nikitalita/PicoCart64/hw/picocart64_v2/README.md

# PicoCart64 v2.0

:exclamation: Do not produce PCBs based on this yet, boards are untested! :exclamation:

## Errata

### v1.0
- TBD

## Changelog

### v1.0
