nikitalita/PicoCart64/hw/picocart64_v2/picocart64_v2-0.png

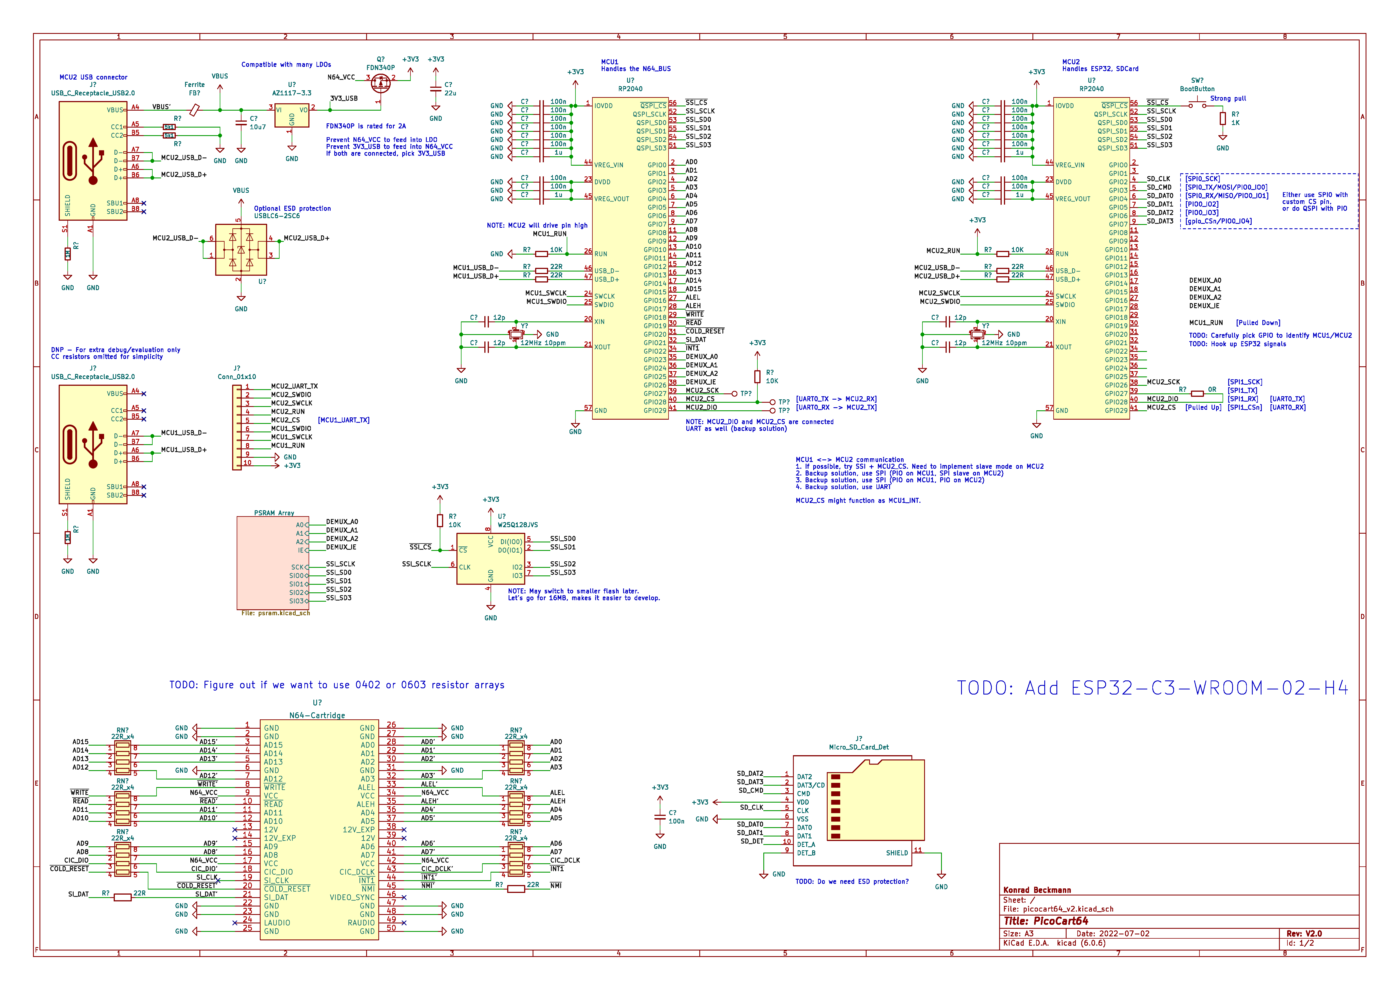
hw/picocart64_v2/picocart64_v2-0.png
