nikitalita/PicoCart64/hw/picocart64_v2/picocart64_v2-1.png

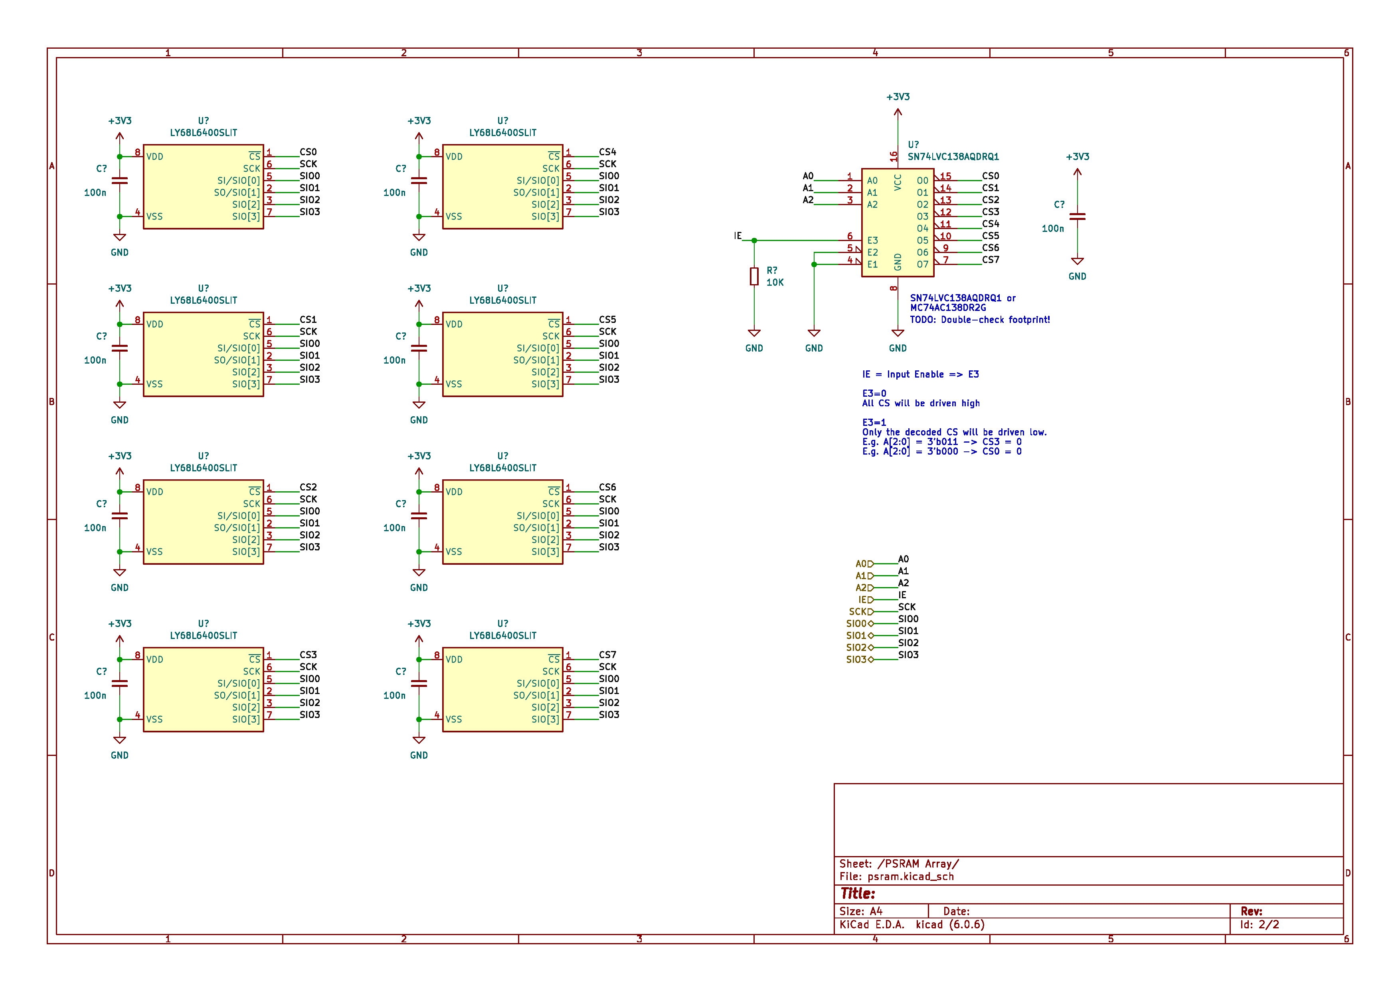
hw/picocart64_v2/picocart64_v2-1.png
