nikitalita/PicoCart64/hw/picocart64_v2/picocart64_v2.pdf

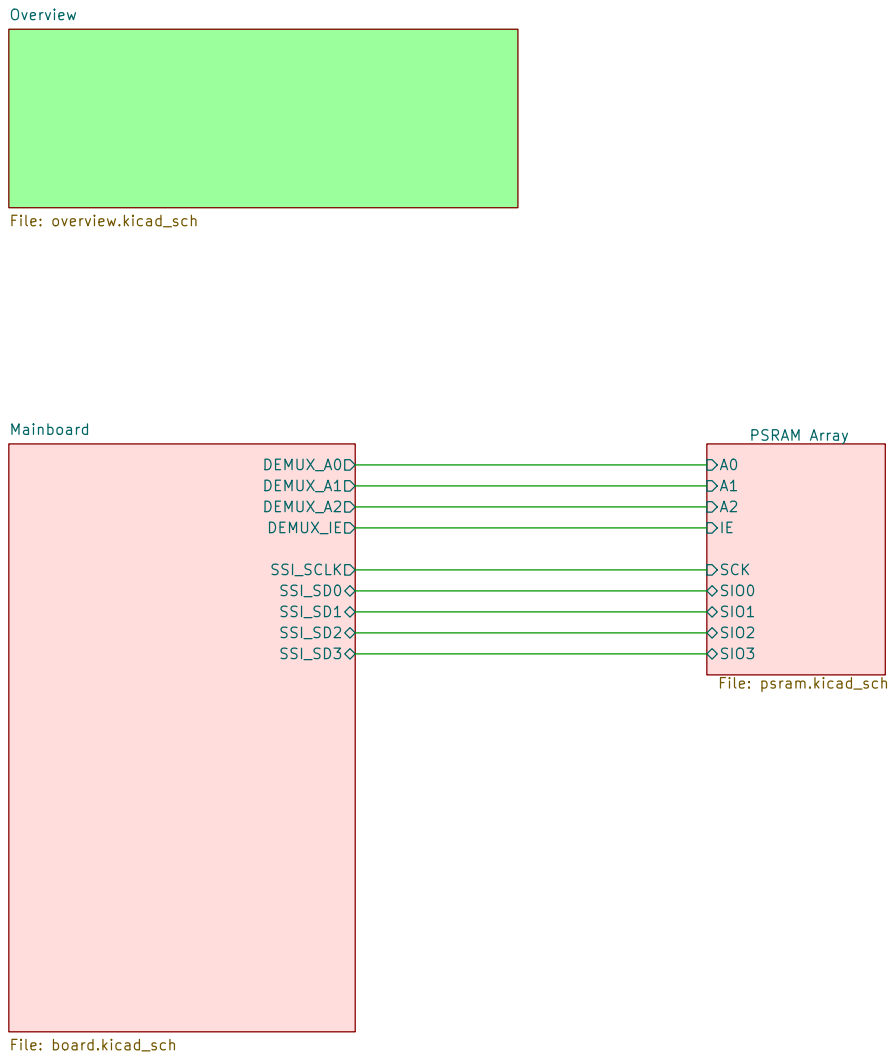
[picture p3: page 1]

File: picocart64_v2.kicad_sch Sheet: / Konrad Beckmann

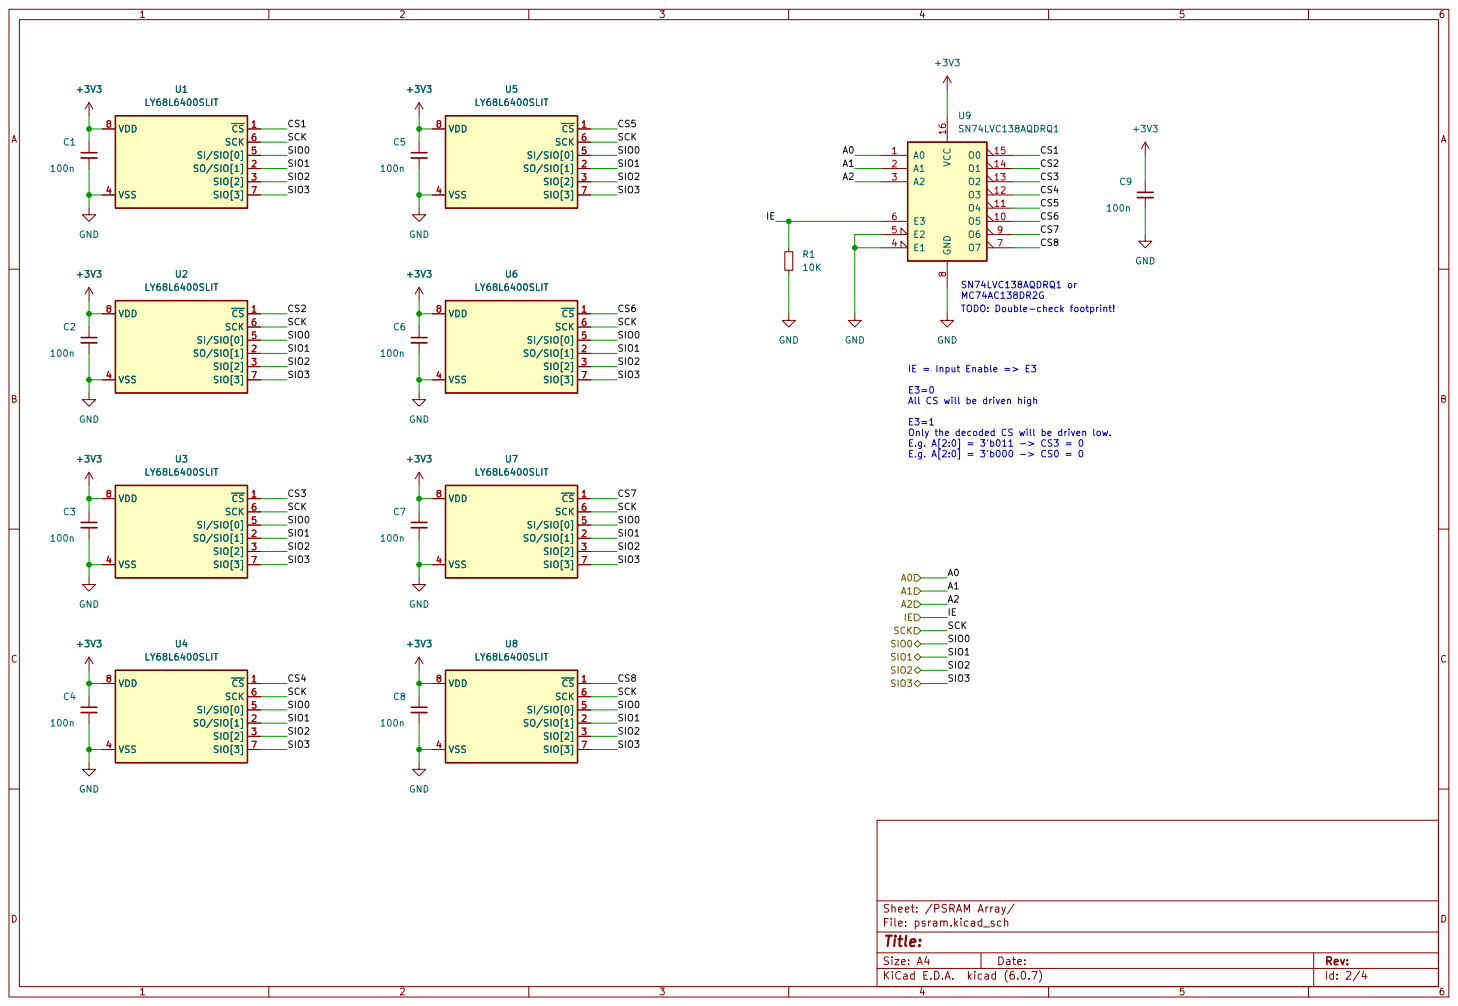
[picture p4: page 2]

TODO: Double-check footprint!

IE = Input Enable => E3 E3=0 All CS will be driven high E3=1 Only the decoded CS will be driven low.

Sheet: /PSRAM Array/ GND

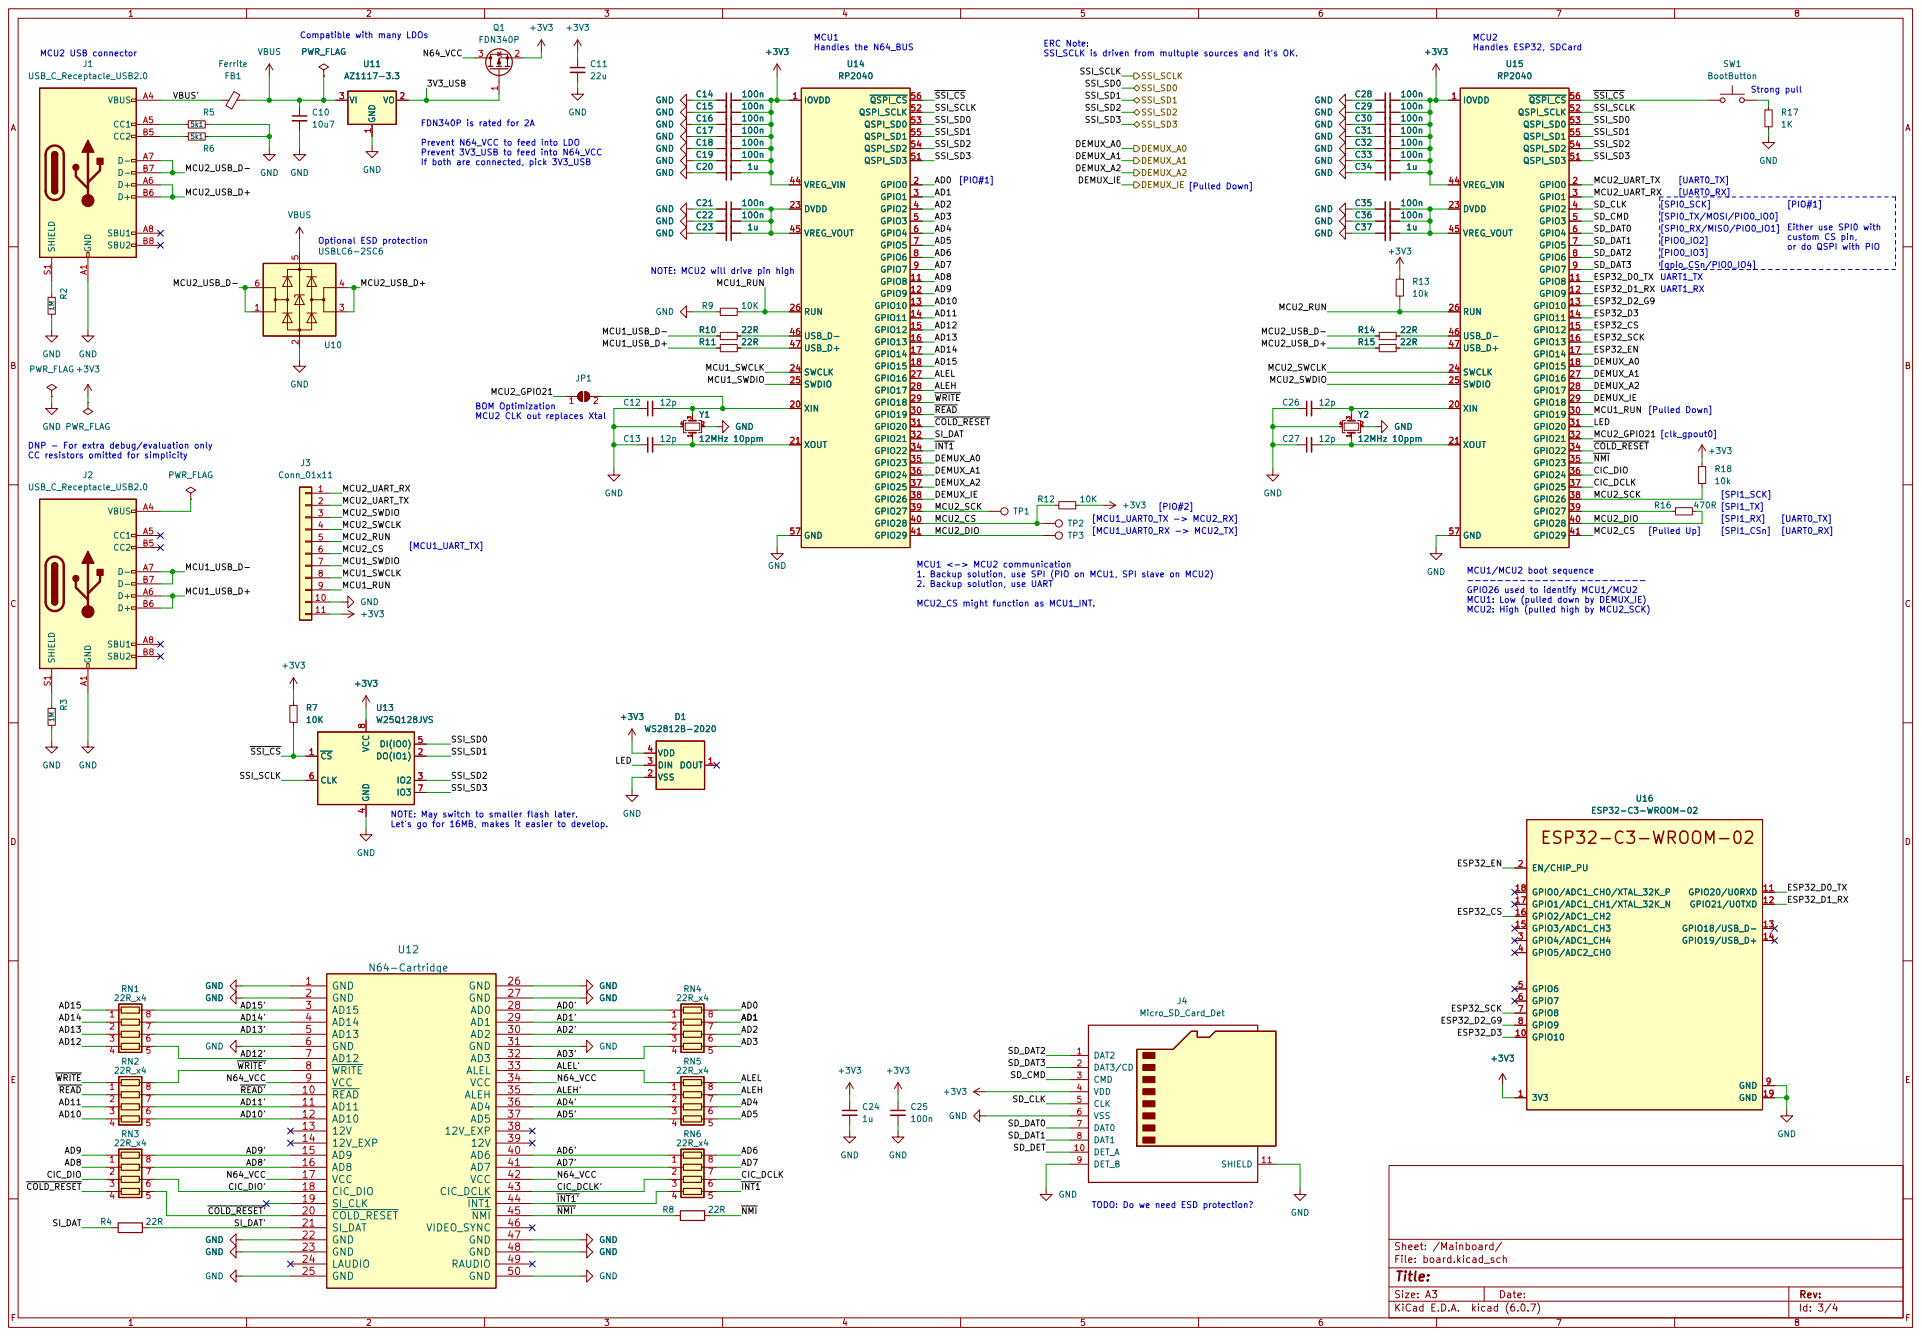
[picture p5: page 3]

[MCU1_UART0_TX -> MCU2_RX] MCU1 Handles the N64_BUS Compatible with many LDOs
PWR_FLAG

[gpio_CSn/PIO0_IO4] ERC Note: SSI_SCLK is driven from multuple sources and it's OK.

1 VO 2 VI 3 U11 AZ1117-3.3 GND GND

Strong pull FDN340P is rated for 2A

Prevent N64_VCC to feed into LDO
Prevent 3V3_USB to feed into N64_VCC
If both are connected, pick 3V3_USB

[PIO0_IO2] UART1_RX NOTE: MCU2 will drive pin high

Either use SPI0 with
custom CS pin, or do QSPI with PIO

BOM Optimization
MCU2 CLK out replaces Xtal

DNP - For extra debug/evaluation only
CC resistors omitted for simplicity
MCU1_USB_D+ CIC_DIO

1. Backup solution, use SPI (PIO on MCU1, SPI slave on MCU2)
2. Backup solution, use UART

MCU1: Low (pulled down by DEMUX_IE)

MCU2: High (pulled high by MCU2_SCK) +3V3 U13 W25Q128JVS

8 D1 WS2812B-2020 DOUT 1 VSS 2 DIN 3 VDD 4 +3V3 R7

NOTE: May switch to smaller flash later.
Let's go for 16MB, makes it easier to develop.

TODO: Do we need ESD protection?

File: board.kicad_sch Sheet: /Mainboard/

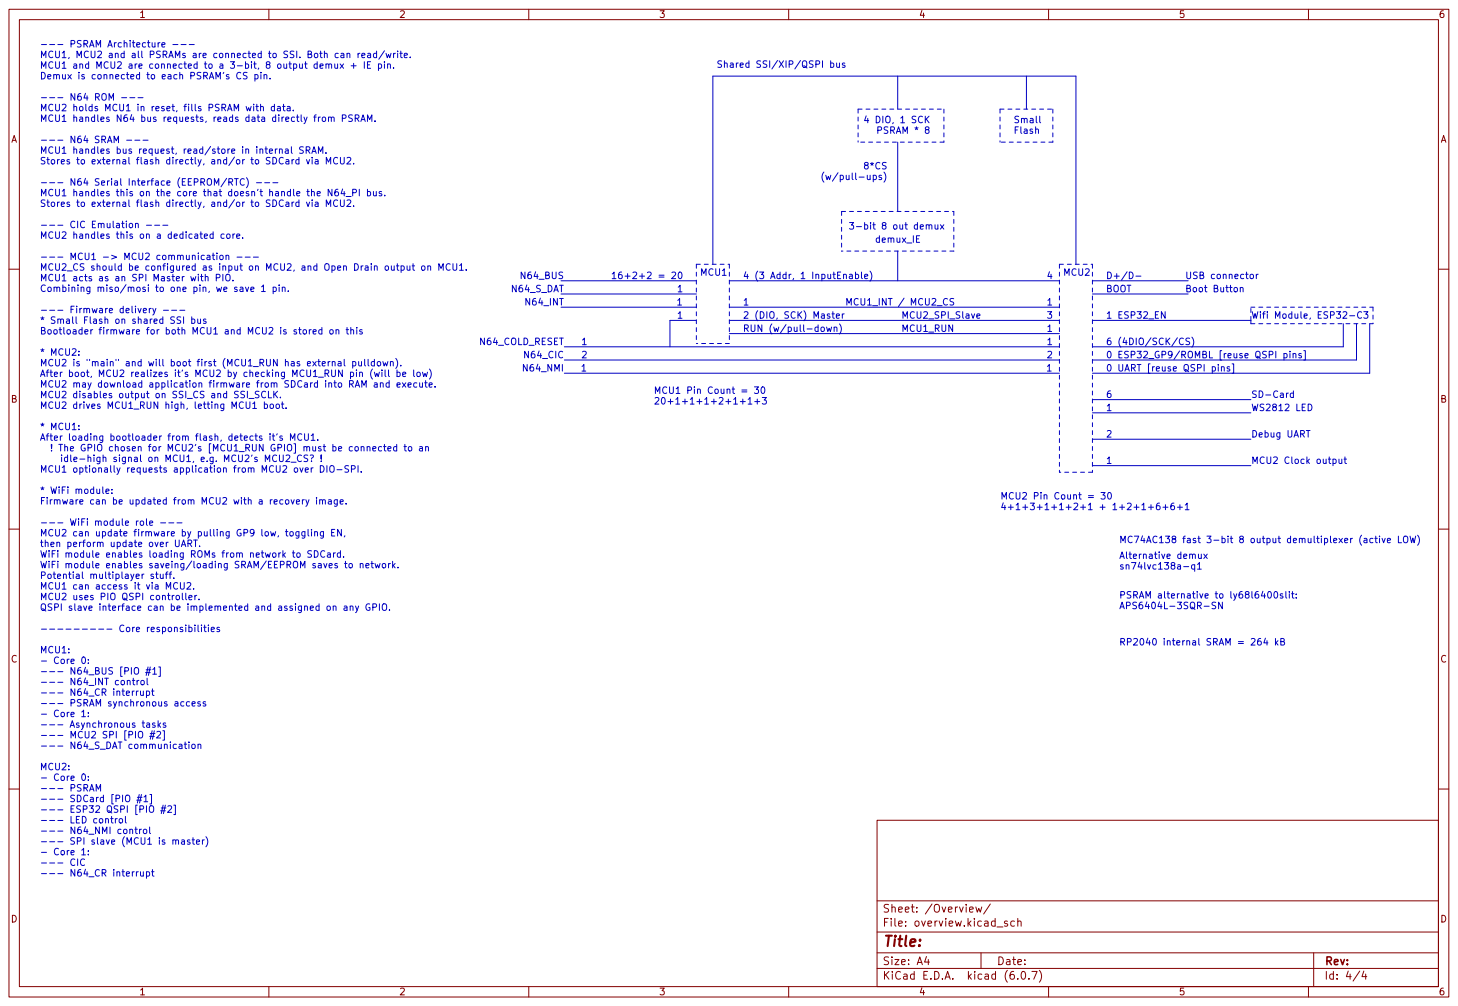
[picture p6: page 4]

--- PSRAM Architecture --- MCU1, MCU2 and all PSRAMs are connected to SSI. Both can read/write. MCU1 and MCU2 are connected to a 3-bit, 8 output demux + IE pin.

Demux is connected to each PSRAM's CS pin. --- N64 ROM --- MCU2 holds MCU1 in reset, fills PSRAM with data. MCU1 handles N64 bus requests, reads data directly from PSRAM. --- N64 SRAM --- MCU1 handles bus request, read/store in internal SRAM.

6 (4DIO/SCK/CS) Small Flash
USB connector PSRAM alternative to ly68l6400slit: APS6404L-3SQR-SN

Stores to external flash directly, and/or to SDCard via MCU2.

--- N64 Serial Interface (EEPROM/RTC) --- MCU1 handles this on the core that doesn't handle the N64_PI bus. Stores to external flash directly, and/or to SDCard via MCU2. --- CIC Emulation --- MCU2 handles this on a dedicated core. --- MCU1 -> MCU2 communication --- MCU2_CS should be configured as input on MCU2, and Open Drain output on MCU1. MCU1 acts as an SPI Master with PIO. Combining miso/mosi to one pin, we save 1 pin.

0 ESP32_GP9/ROMBL [reuse QSPI pins] demux_IE

--- Firmware delivery --- * Small Flash on shared SSI bus Bootloader firmware for both MCU1 and MCU2 is stored on this

* MCU2: MCU2 is "main" and will boot first (MCU1_RUN has external pulldown).

After boot, MCU2 realizes it's MCU2 by checking MCU1_RUN pin (will be low)
MCU2 may download application firmware from SDCard into RAM and execute.
MCU2 disables output on SSI_CS and SSI_SCLK.
MCU2 drives MCU1_RUN high, letting MCU1 boot. * MCU1: After loading bootloader from flash, detects it's MCU1.

0 UART [reuse QSPI pins]

! The GPIO chosen for MCU2's [MCU1_RUN GPIO] must be connected to an
idle-high signal on MCU1, e.g. MCU2's MCU2_CS? !
MCU1 optionally requests application from MCU2 over DIO-SPI. * WiFi module: Firmware can be updated from MCU2 with a recovery image. --- WiFi module role --- MCU2 can update firmware by pulling GP9 low, toggling EN,

then perform update over UART.
WiFi module enables loading ROMs from network to SDCard.
WiFi module enables saveing/loading SRAM/EEPROM saves to network.
Potential multiplayer stuff. MCU1 can access it via MCU2. MCU2 uses PIO QSPI controller. QSPI slave interface can be implemented and assigned on any GPIO.

--------- Core responsibilities MCU1: - Core 0: --- N64_BUS [PIO #1] --- N64_INT control --- N64_CR interrupt

--- MCU2 SPI [PIO #2] --- N64_S_DAT communication MCU2: - Core 0: --- PSRAM

--- SDCard [PIO #1]
--- ESP32 QSPI [PIO #2] --- LED control --- N64_NMI control --- SPI slave (MCU1 is master)

File: overview.kicad_sch Sheet: /Overview/
Id: 4/4 Title:
