nikitalita/PicoCart64/hw/picocart64_v2/picocart64_v2.kicad_pcb

## KiCad design hw/picocart64_v2/picocart64_v2.kicad_pcb (2022-08-11)

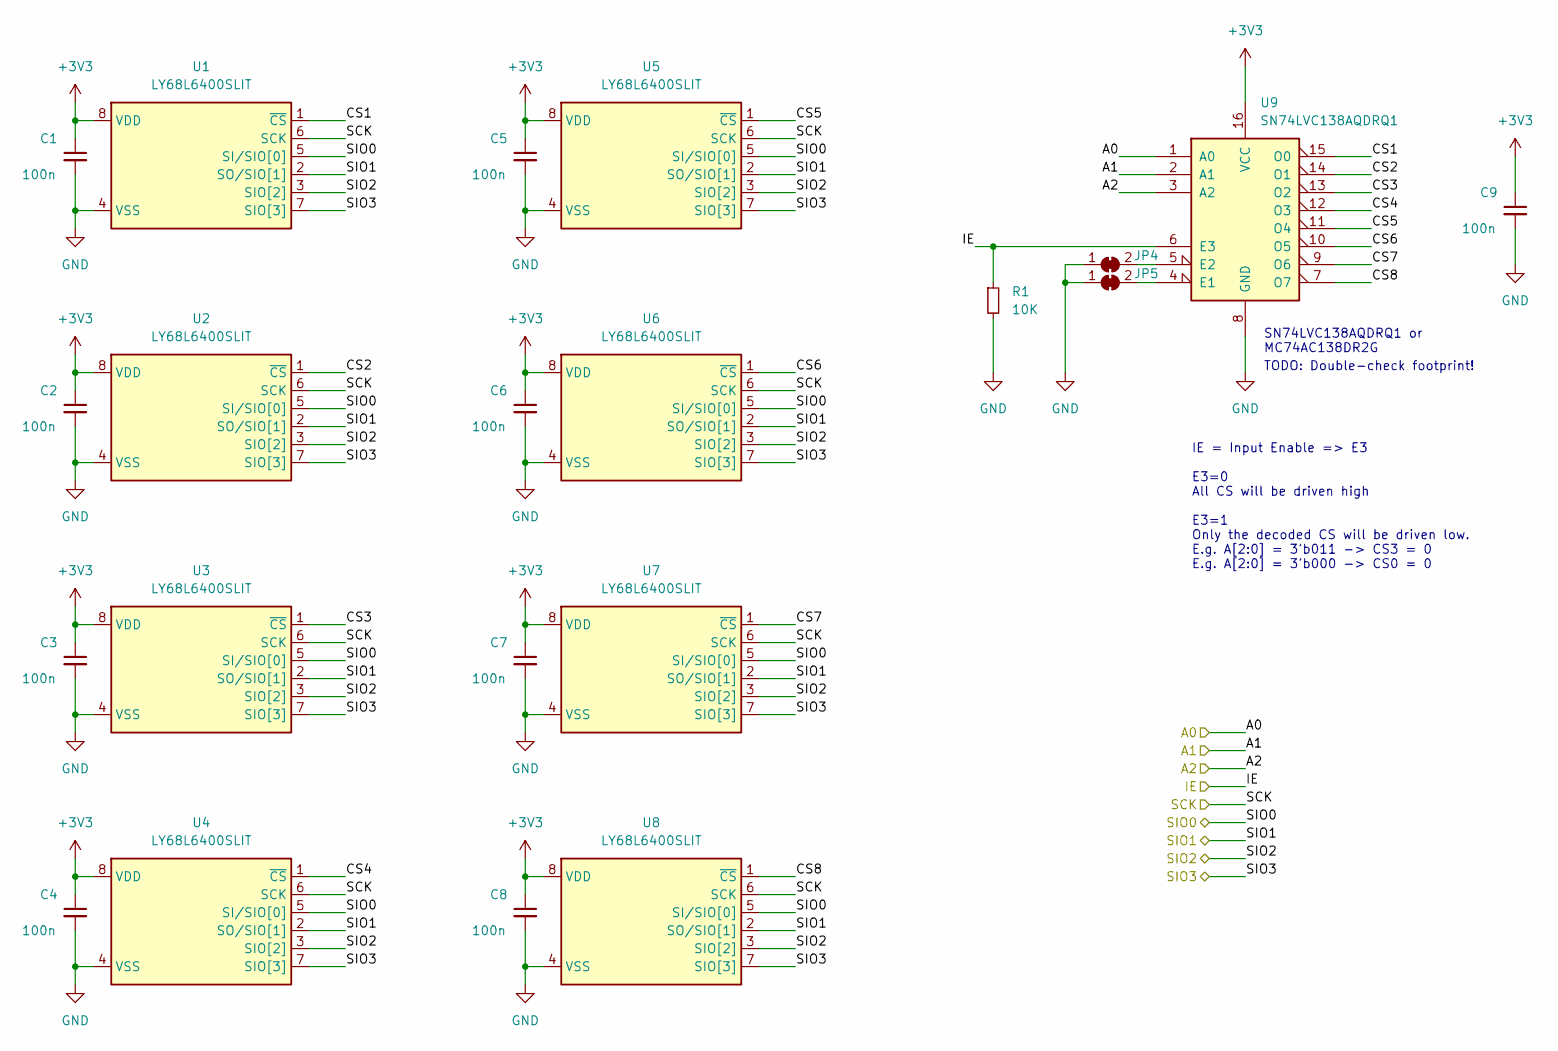
[picture p7: schematic psram.kicad_sch]

Parts:
C1, C2, C3, C4, C5, C6, C7, C8, C9: 100n; C_0402_1005Metric
JP4, JP5: SolderJumper_2_Bridged; SolderJumper-2_Small_Closed
R1: 10K; R_0402_1005Metric
U1, U2, U3, U4, U5, U6, U7, U8: LY68L6400SLIT; SOIC-8_5.275x5.275mm_P1.27mm
U9: SN74LVC138AQDRQ1; SOP-16_4.4x10.4mm_P1.27mm

Connections:
+3V3: C1.1, C2.1, C3.1, C4.1, C5.1, C6.1, C7.1, C8.1, C9.1, U1.8 (VDD), U2.8 (VDD), U3.8 (VDD), U4.8 (VDD), U5.8 (VDD), U6.8 (VDD), U7.8 (VDD), U8.8 (VDD), U9.16 (VCC); also elsewhere on the board
/Mainboard/DEMUX_A0: U9.1 (A0); also elsewhere on the board
/Mainboard/DEMUX_A1: U9.2 (A1); also elsewhere on the board
/Mainboard/DEMUX_A2: U9.3 (A2); also elsewhere on the board
/Mainboard/DEMUX_IE: R1.1, U9.6 (E3); also elsewhere on the board
/Mainboard/SSI_SCLK: U1.6 (SCK), U2.6 (SCK), U3.6 (SCK), U4.6 (SCK), U5.6 (SCK), U6.6 (SCK), U7.6 (SCK), U8.6 (SCK); also elsewhere on the board
/Mainboard/SSI_SD0: U1.5 (SI/SIO[0]), U2.5 (SI/SIO[0]), U3.5 (SI/SIO[0]), U4.5 (SI/SIO[0]), U5.5 (SI/SIO[0]), U6.5 (SI/SIO[0]), U7.5 (SI/SIO[0]), U8.5 (SI/SIO[0]); also elsewhere on the board
/Mainboard/SSI_SD1: U1.2 (SO/SIO[1]), U2.2 (SO/SIO[1]), U3.2 (SO/SIO[1]), U4.2 (SO/SIO[1]), U5.2 (SO/SIO[1]), U6.2 (SO/SIO[1]), U7.2 (SO/SIO[1]), U8.2 (SO/SIO[1]); also elsewhere on the board
/Mainboard/SSI_SD2: U1.3 (SIO[2]), U2.3 (SIO[2]), U3.3 (SIO[2]), U4.3 (SIO[2]), U5.3 (SIO[2]), U6.3 (SIO[2]), U7.3 (SIO[2]), U8.3 (SIO[2]); also elsewhere on the board
/Mainboard/SSI_SD3: U1.7 (SIO[3]), U2.7 (SIO[3]), U3.7 (SIO[3]), U4.7 (SIO[3]), U5.7 (SIO[3]), U6.7 (SIO[3]), U7.7 (SIO[3]), U8.7 (SIO[3]); also elsewhere on the board
/PSRAM Array/CS1: U1.1 (~CS), U9.15 (O0)
/PSRAM Array/CS2: U2.1 (~CS), U9.14 (O1)
/PSRAM Array/CS3: U3.1 (~CS), U9.13 (O2)
/PSRAM Array/CS4: U4.1 (~CS), U9.12 (O3)
/PSRAM Array/CS5: U5.1 (~CS), U9.11 (O4)
/PSRAM Array/CS6: U6.1 (~CS), U9.10 (O5)
/PSRAM Array/CS7: U7.1 (~CS), U9.9 (O6)
/PSRAM Array/CS8: U8.1 (~CS), U9.7 (O7)
GND: C1.2, C2.2, C3.2, C4.2, C5.2, C6.2, C7.2, C8.2, C9.2, JP4.1 (A), JP5.1 (A), R1.2, U1.4 (VSS), U2.4 (VSS), U3.4 (VSS), U4.4 (VSS), U5.4 (VSS), U6.4 (VSS), U7.4 (VSS), U8.4 (VSS), U9.8 (GND); also elsewhere on the board
unnamed: JP4.2 (B), U9.5 (E2)
unnamed: JP5.2 (B), U9.4 (E1)

Notes on the sheet:
TODO: Double-check footprint!
IE = Input Enable => E3 E3=0 All CS will be driven high E3=1 Only the decoded CS will be driven low. E.g. A[2:0] = 3'b011 -> CS3 = 0 E.g. A[2:0] = 3'b000 -> CS0 = 0
SN74LVC138AQDRQ1 or MC74AC138DR2G

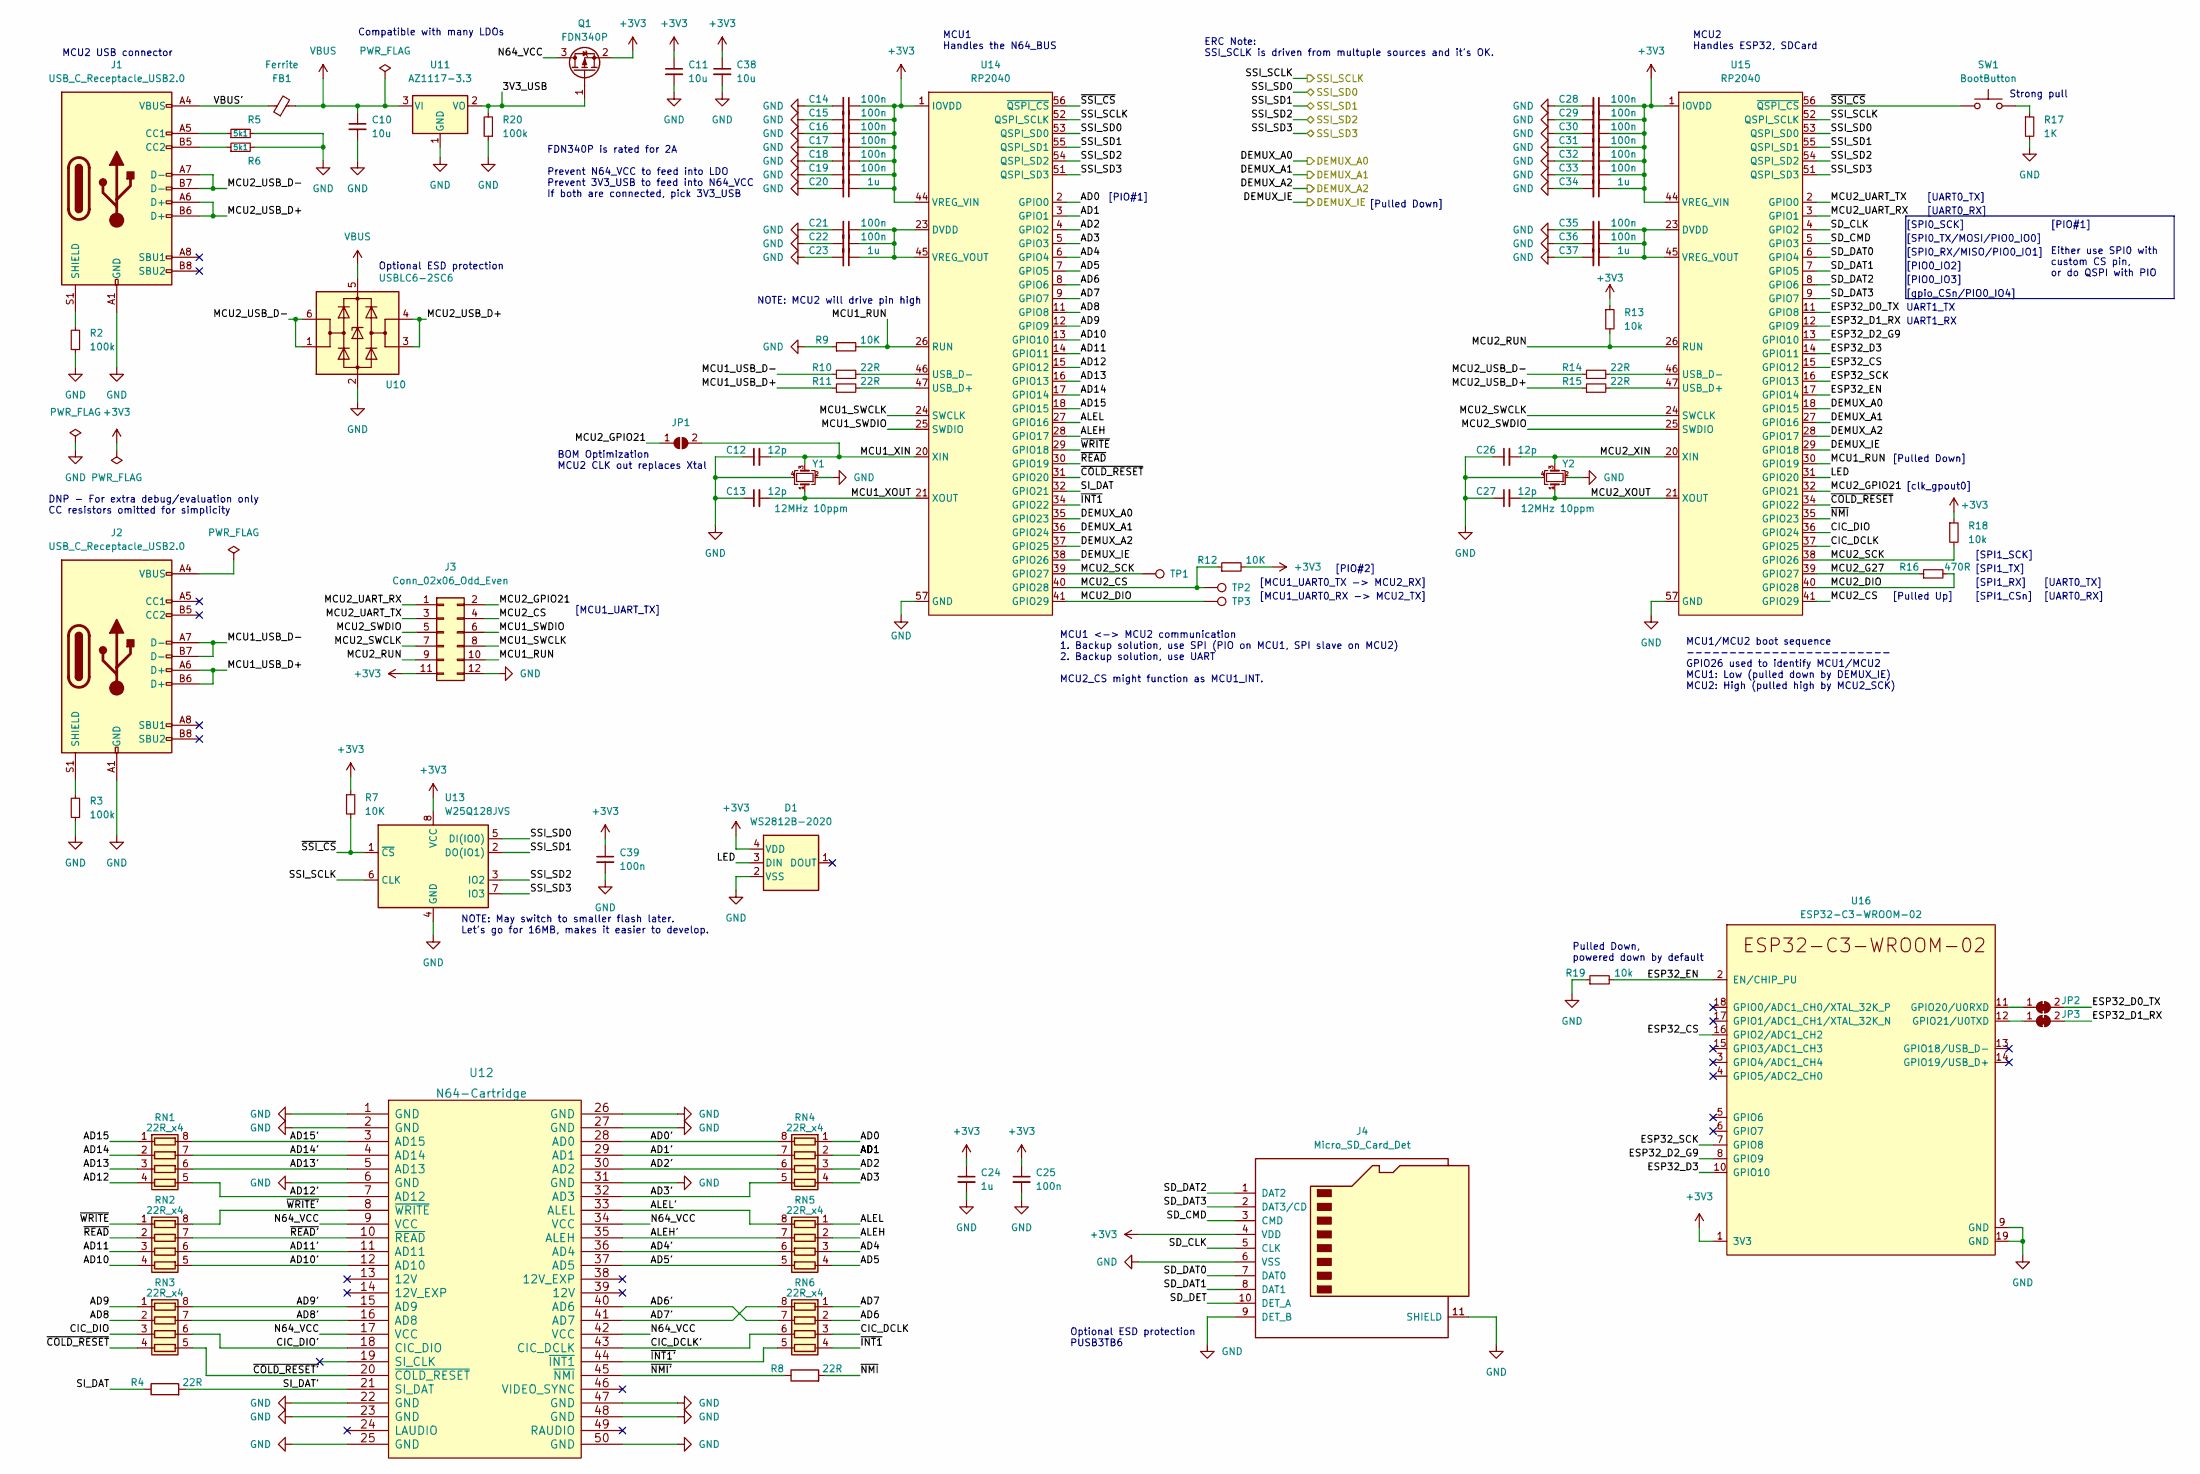
[picture p8: schematic board.kicad_sch]

Parts:
C10, C11, C38: 10u; C_0603_1608Metric
C12, C13, C26, C27: 12p; C_0402_1005Metric
C14, C15, C16, C17, C18, C19, C21, C22, C25, C28, C29, C30, C31, C32, C33, C35, C36, C39: 100n; C_0402_1005Metric
C20, C23, C24, C34, C37: 1u; C_0402_1005Metric
D1: WS2812B-2020
FB1: Ferrite; L_0603_1608Metric
J1, J2: USB_C_Receptacle_USB2.0; USB_C_Receptacle_GT-USB-7010
J3: Conn_02x06_Odd_Even; PinHeader_2x06_P2.54mm_Vertical_SMD
J4: Micro_SD_Card_Det; microSD_HC_Molex_104031-0811
JP1: SolderJumper_2_Open; SolderJumper-2_Small_Open
JP2, JP3: SolderJumper_2_Bridged; SolderJumper-2_Small_Closed
Q1: FDN340P; SOT-23; LCSC C347510
R2, R3, R20: 100k; R_0402_1005Metric
R4, R8, R10, R11, R14, R15: 22R; R_0402_1005Metric
R5, R6: 5k1; R_0402_1005Metric
R7, R9, R12: 10K; R_0402_1005Metric
R13, R18, R19: 10k; R_0402_1005Metric
R16: 470R; R_0402_1005Metric
R17: 1K; R_0402_1005Metric
RN1, RN2, RN3, RN4, RN5, RN6: 22R_x4; R_Array_Convex_4x0402
SW1: BootButton; SW_SPST_FSMSM
TP1: TP_MCU2_SCK; TestPoint_Pad_D1.0mm
TP2: TP_MCU2_CS; TestPoint_Pad_D1.0mm
TP3: TP_MCU2_DIO; TestPoint_Pad_D1.0mm
U10: USBLC6-2SC6; SOT-23-6; LCSC1 C15999
U11: AZ1117-3.3; SOT-223
U12: N64-Cartridge; N64-Connector
U13: W25Q128JVS; SOIC-8_5.23x5.23mm_P1.27mm
U14, U15: RP2040; QFN-56_EP_7x7_Pitch0.4mm
U16: ESP32-C3-WROOM-02
Y1, Y2: 12MHz 10ppm; Crystal_SMD_2520-4Pin_2.5x2.0mm; LCSC C521567

Connections:
+3V3: C11.1, C14.1, C15.1, C16.1, C17.1, C18.1, C19.1, C20.1, C24.1, C25.1, C28.1, C29.1, C30.1, C31.1, C32.1, C33.1, C34.1, C38.1, C39.1, D1.4 (VDD), J3.11, J4.4 (VDD), Q1.2 (S), R7.1, R12.2, R13.1, R18.1, U13.8 (VCC), U14.1 (IOVDD), U14.10 (IOVDD), U14.22 (IOVDD), U14.33 (IOVDD), U14.42 (IOVDD), U14.43 (ADC_AVDD), U14.44 (VREG_VIN), U14.48 (USB_VDD), U14.49 (IOVDD), U15.1 (IOVDD), U15.10 (IOVDD), U15.22 (IOVDD), U15.33 (IOVDD), U15.42 (IOVDD), U15.43 (ADC_AVDD), U15.44 (VREG_VIN), U15.48 (USB_VDD), U15.49 (IOVDD), U16.1 (3V3); also elsewhere on the board
/Mainboard/3V3_USB: Q1.1 (G), R20.2, U11.2 (VO)
/Mainboard/AD0: RN4.1 (R1.1), U14.2 (GPIO0)
/Mainboard/AD0': RN4.8 (R1.2), U12.28 (AD0)
/Mainboard/AD1: RN4.2 (R2.1), U14.3 (GPIO1)
/Mainboard/AD1': RN4.7 (R2.2), U12.29 (AD1)
/Mainboard/AD2: RN4.3 (R3.1), U14.4 (GPIO2)
/Mainboard/AD2': RN4.6 (R3.2), U12.30 (AD2)
/Mainboard/AD3: RN4.4 (R4.1), U14.5 (GPIO3)
/Mainboard/AD3': RN4.5 (R4.2), U12.32 (AD3)
/Mainboard/AD4: RN5.3 (R3.1), U14.6 (GPIO4)
/Mainboard/AD4': RN5.6 (R3.2), U12.36 (AD4)
/Mainboard/AD5: RN5.4 (R4.1), U14.7 (GPIO5)
/Mainboard/AD5': RN5.5 (R4.2), U12.37 (AD5)
/Mainboard/AD6: RN6.2 (R2.1), U14.8 (GPIO6)
/Mainboard/AD6': RN6.7 (R2.2), U12.40 (AD6)
/Mainboard/AD7: RN6.1 (R1.1), U14.9 (GPIO7)
/Mainboard/AD7': RN6.8 (R1.2), U12.41 (AD7)
/Mainboard/AD8: RN3.2 (R2.1), U14.11 (GPIO8)
/Mainboard/AD8': RN3.7 (R2.2), U12.16 (AD8)
/Mainboard/AD9: RN3.1 (R1.1), U14.12 (GPIO9)
/Mainboard/AD9': RN3.8 (R1.2), U12.15 (AD9)
/Mainboard/AD10: RN2.4 (R4.1), U14.13 (GPIO10)
/Mainboard/AD10': RN2.5 (R4.2), U12.12 (AD10)
/Mainboard/AD11: RN2.3 (R3.1), U14.14 (GPIO11)
/Mainboard/AD11': RN2.6 (R3.2), U12.11 (AD11)
/Mainboard/AD12: RN1.4 (R4.1), U14.15 (GPIO12)
/Mainboard/AD12': RN1.5 (R4.2), U12.7 (AD12)
/Mainboard/AD13: RN1.3 (R3.1), U14.16 (GPIO13)
/Mainboard/AD13': RN1.6 (R3.2), U12.5 (AD13)
/Mainboard/AD14: RN1.2 (R2.1), U14.17 (GPIO14)
/Mainboard/AD14': RN1.7 (R2.2), U12.4 (AD14)
/Mainboard/AD15: RN1.1 (R1.1), U14.18 (GPIO15)
/Mainboard/AD15': RN1.8 (R1.2), U12.3 (AD15)
/Mainboard/ALEH: RN5.2 (R2.1), U14.28 (GPIO17)
/Mainboard/ALEH': RN5.7 (R2.2), U12.35 (ALEH)
/Mainboard/ALEL: RN5.1 (R1.1), U14.27 (GPIO16)
/Mainboard/ALEL': RN5.8 (R1.2), U12.33 (ALEL)
/Mainboard/CIC_DCLK: RN6.3 (R3.1), U15.37 (GPIO25)
/Mainboard/CIC_DCLK': RN6.6 (R3.2), U12.43 (CIC_DCLK)
/Mainboard/CIC_DIO: RN3.3 (R3.1), U15.36 (GPIO24)
/Mainboard/CIC_DIO': RN3.6 (R3.2), U12.18 (CIC_DIO)
/Mainboard/DEMUX_A0: U14.35 (GPIO23), U15.18 (GPIO15); also elsewhere on the board
/Mainboard/DEMUX_A1: U14.36 (GPIO24), U15.27 (GPIO16); also elsewhere on the board
/Mainboard/DEMUX_A2: U14.37 (GPIO25), U15.28 (GPIO17); also elsewhere on the board
/Mainboard/DEMUX_IE: U14.38 (GPIO26), U15.29 (GPIO18); also elsewhere on the board
/Mainboard/ESP32_CS: U15.15 (GPIO12), U16.16 (GPIO2/ADC1_CH2)
/Mainboard/ESP32_D0_TX: JP2.2 (B), U15.11 (GPIO8)
/Mainboard/ESP32_D1_RX: JP3.2 (B), U15.12 (GPIO9)
/Mainboard/ESP32_D2_G9: U15.13 (GPIO10), U16.8 (GPIO9)
/Mainboard/ESP32_D3: U15.14 (GPIO11), U16.10 (GPIO10)
/Mainboard/ESP32_EN: R19.2, U15.17 (GPIO14), U16.2 (EN/CHIP_PU)
/Mainboard/ESP32_SCK: U15.16 (GPIO13), U16.7 (GPIO8)
/Mainboard/LED: D1.3 (DIN), U15.31 (GPIO20)
/Mainboard/MCU1_RUN: J3.10, R9.2, U14.26 (RUN), U15.30 (GPIO19)
/Mainboard/MCU1_SWCLK: J3.8, U14.24 (SWCLK)
/Mainboard/MCU1_SWDIO: J3.6, U14.25 (SWDIO)
/Mainboard/MCU1_USB_D+: J2.A6 (D+), J2.B6 (D+), R11.1
/Mainboard/MCU1_USB_D-: J2.A7 (D-), J2.B7 (D-), R10.1
/Mainboard/MCU1_XIN: C12.2, JP1.2 (B), U14.20 (XIN), Y1.3
/Mainboard/MCU1_XOUT: C13.2, U14.21 (XOUT), Y1.1
/Mainboard/MCU2_CS: J3.4, R12.1, TP2.1, U14.40 (GPIO28), U15.41 (GPIO29)
/Mainboard/MCU2_DIO: R16.2, TP3.1, U14.41 (GPIO29), U15.40 (GPIO28)
/Mainboard/MCU2_G27: R16.1, U15.39 (GPIO27)
/Mainboard/MCU2_GPIO21: J3.2, JP1.1 (A), U15.32 (GPIO21)
/Mainboard/MCU2_RUN: J3.9, R13.2, U15.26 (RUN)
/Mainboard/MCU2_SCK: R18.2, TP1.1, U14.39 (GPIO27), U15.38 (GPIO26)
/Mainboard/MCU2_SWCLK: J3.7, U15.24 (SWCLK)
/Mainboard/MCU2_SWDIO: J3.5, U15.25 (SWDIO)
/Mainboard/MCU2_UART_RX: J3.1, U15.3 (GPIO1)
/Mainboard/MCU2_UART_TX: J3.3, U15.2 (GPIO0)
/Mainboard/MCU2_USB_D+: J1.A6 (D+), J1.B6 (D+), R15.1, U10.3 (I/O2), U10.4 (I/O2)
/Mainboard/MCU2_USB_D-: J1.A7 (D-), J1.B7 (D-), R14.1, U10.1 (I/O1), U10.6 (I/O1)
/Mainboard/MCU2_XIN: C26.2, U15.20 (XIN), Y2.3
/Mainboard/MCU2_XOUT: C27.2, U15.21 (XOUT), Y2.1
/Mainboard/N64_VCC: Q1.3 (D), U12.9 (VCC), U12.17 (VCC), U12.34 (VCC), U12.42 (VCC)
/Mainboard/SD_CLK: J4.5 (CLK), U15.4 (GPIO2)
/Mainboard/SD_CMD: J4.3 (CMD), U15.5 (GPIO3)
/Mainboard/SD_DAT0: J4.7 (DAT0), U15.6 (GPIO4)
/Mainboard/SD_DAT1: J4.8 (DAT1), U15.7 (GPIO5)
/Mainboard/SD_DAT2: J4.1 (DAT2), U15.8 (GPIO6)
/Mainboard/SD_DAT3: J4.2 (DAT3/CD), U15.9 (GPIO7)
/Mainboard/SD_DET: J4.10 (DET_A)
/Mainboard/SI_DAT: R4.1, U14.32 (GPIO21)
/Mainboard/SI_DAT': R4.2, U12.21 (SI_DAT)
/Mainboard/SSI_SCLK: U13.6 (CLK), U14.52 (QSPI_SCLK), U15.52 (QSPI_SCLK); also elsewhere on the board
/Mainboard/SSI_SD0: U13.5 (DI(IO0)), U14.53 (QSPI_SD0), U15.53 (QSPI_SD0); also elsewhere on the board
/Mainboard/SSI_SD1: U13.2 (DO(IO1)), U14.55 (QSPI_SD1), U15.55 (QSPI_SD1); also elsewhere on the board
/Mainboard/SSI_SD2: U13.3 (IO2), U14.54 (QSPI_SD2), U15.54 (QSPI_SD2); also elsewhere on the board
/Mainboard/SSI_SD3: U13.7 (IO3), U14.51 (QSPI_SD3), U15.51 (QSPI_SD3); also elsewhere on the board
/Mainboard/VBUS': FB1.1, J1.A4 (VBUS), J1.A9 (VBUS), J1.B4 (VBUS), J1.B9 (VBUS)
/Mainboard/~COLD_RESET': RN3.5 (R4.2), U12.20 (~COLD_RESET)
/Mainboard/~COLD_RESET: RN3.4 (R4.1), U14.31 (GPIO20), U15.34 (GPIO22)
/Mainboard/~INT1': RN6.5 (R4.2), U12.44 (~INT1)
/Mainboard/~INT1: RN6.4 (R4.1), U14.34 (GPIO22)
/Mainboard/~NMI': R8.1, U12.45 (~NMI)
/Mainboard/~NMI: R8.2, U15.35 (GPIO23)
/Mainboard/~READ': RN2.7 (R2.2), U12.10 (~READ)
/Mainboard/~READ: RN2.2 (R2.1), U14.30 (GPIO19)
/Mainboard/~SSI_CS: R7.2, SW1.1, U13.1 (~CS), U14.56 (~QSPI_CS), U15.56 (~QSPI_CS)
/Mainboard/~WRITE': RN2.8 (R1.2), U12.8 (~WRITE)
/Mainboard/~WRITE: RN2.1 (R1.1), U14.29 (GPIO18)
GND: C10.2, C11.2, C12.1, C13.1, C14.2, C15.2, C16.2, C17.2, C18.2, C19.2, C20.2, C21.2, C22.2, C23.2, C24.2, C25.2, C26.1, C27.1, C28.2, C29.2, C30.2, C31.2, C32.2, C33.2, C34.2, C35.2, C36.2, C37.2, C38.2, C39.2, D1.2 (VSS), J1.A1 (GND), J1.A12 (GND), J1.B1 (GND), J1.B12 (GND), J2.A1 (GND), J2.A12 (GND), J2.B1 (GND), J2.B12 (GND), J3.12, J4.6 (VSS), J4.9 (DET_B), J4.11 (SHIELD), R2.1, R3.1, R5.2, R6.2, R9.1, R17.2, R19.1, R20.1, U10.2 (GND), U11.1 (GND), U12.1 (GND), U12.2 (GND), U12.6 (GND), U12.22 (GND), U12.23 (GND), U12.25 (GND), U12.26 (GND), U12.27 (GND), U12.31 (GND), U12.47 (GND), U12.48 (GND), U12.50 (GND), U13.4 (GND), U14.19 (TESTEN), U14.57 (GND), U15.19 (TESTEN), U15.57 (GND), U16.9 (GND), U16.19 (GND), Y1.2, Y1.4, Y2.2, Y2.4; also elsewhere on the board
unnamed: C21.1, C22.1, C23.1, U14.23 (DVDD), U14.45 (VREG_VOUT), U14.50 (DVDD)
unnamed: C35.1, C36.1, C37.1, U15.23 (DVDD), U15.45 (VREG_VOUT), U15.50 (DVDD)
unnamed: J1.A5 (CC1), R5.1
unnamed: J1.B5 (CC2), R6.1
unnamed: J1.S1 (SHIELD), R2.2
unnamed: J2.A4 (VBUS), J2.A9 (VBUS), J2.B4 (VBUS), J2.B9 (VBUS)
unnamed: J2.S1 (SHIELD), R3.2
unnamed: JP2.1 (A), U16.11 (GPIO20/U0RXD)
unnamed: JP3.1 (A), U16.12 (GPIO21/U0TXD)
unnamed: R10.2, U14.46 (USB_D-)
unnamed: R11.2, U14.47 (USB_D+)
unnamed: R14.2, U15.46 (USB_D-)
unnamed: R15.2, U15.47 (USB_D+)
unnamed: R17.1, SW1.2
VBUS: C10.1, FB1.2, U10.5 (VBUS), U11.3 (VI)

Notes on the sheet:
[UART0_TX]
[PIO0_IO2]
[Pulled Up]
[clk_gpout0]
UART1_TX
[MCU1_UART0_RX -> MCU2_TX]
NOTE: MCU2 will drive pin high
[Pulled Down]
Strong pull
[UART0_RX]
MCU2 Handles ESP32, SDCard
FDN340P is rated for 2A Prevent N64_VCC to feed into LDO Prevent 3V3_USB to feed into N64_VCC If both are connected, pick 3V3_USB
Optional ESD protection PUSB3TB6
[PIO#1]
Compatible with many LDOs
NOTE: May switch to smaller flash later. Let's go for 16MB, makes it easier to develop.
UART1_RX
BOM Optimization MCU2 CLK out replaces Xtal
[SPI1_SCK]
[SPI0_TX/MOSI/PIO0_IO0]
MCU1/MCU2 boot sequence ------------------------ GPIO26 used to identify MCU1/MCU2 MCU1: Low (pulled down by DEMUX_IE) MCU2: High (pulled high by MCU2_SCK)
[SPI0_SCK]
Either use SPI0 with custom CS pin, or do QSPI with PIO
[MCU1_UART_TX]
[SPI1_TX]
[MCU1_UART0_TX -> MCU2_RX]
[SPI1_RX]
ERC Note: SSI_SCLK is driven from multuple sources and it's OK.
MCU2 USB connector
[PIO0_IO3]
[PIO#2]
Optional ESD protection
MCU1 <-> MCU2 communication 1. Backup solution, use SPI (PIO on MCU1, SPI slave on MCU2) 2. Backup solution, use UART MCU2_CS might function as MCU1_INT.
[SPI0_RX/MISO/PIO0_IO1]
Pulled Down, powered down by default
DNP - For extra debug/evaluation only CC resistors omitted for simplicity
MCU1 Handles the N64_BUS
[gpio_CSn/PIO0_IO4]
[SPI1_CSn]

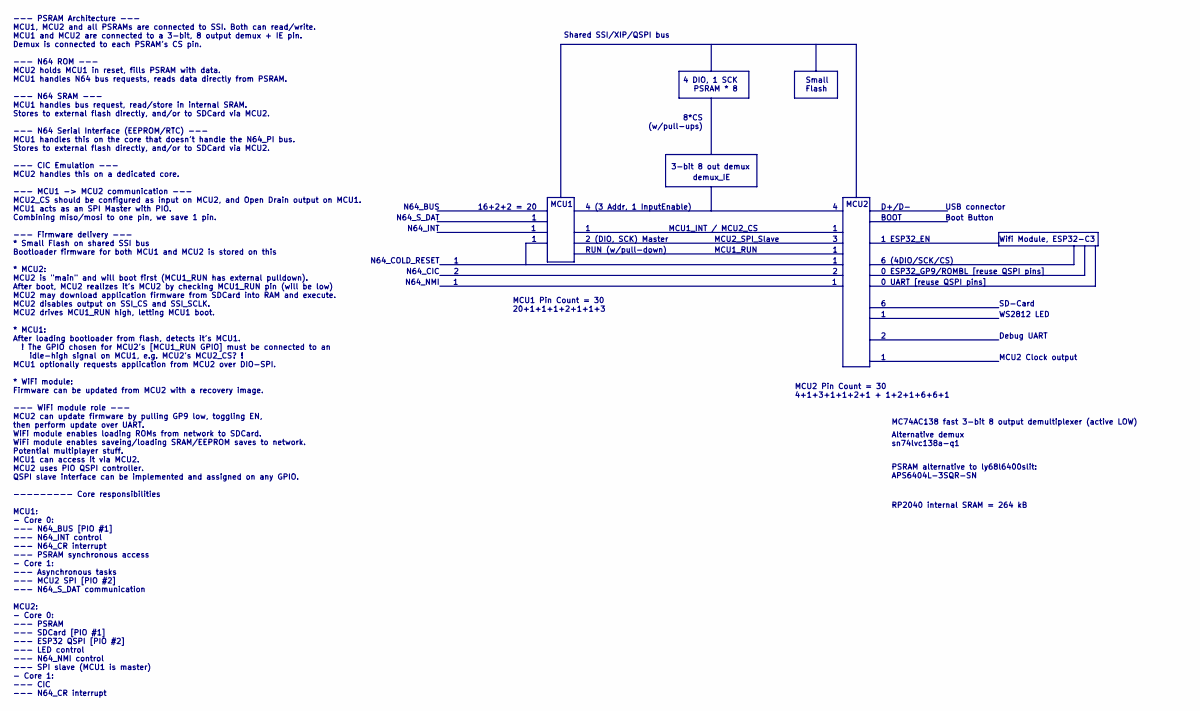
[picture p9: schematic overview.kicad_sch]

Notes on the sheet:
MCU1_RUN
Alternative demux sn74lvc138a-q1
4 DIO, 1 SCK PSRAM * 8
16+2+2 = 20
1 ESP32_EN
0 UART [reuse QSPI pins]
PSRAM alternative to ly68l6400slit: APS6404L-3SQR-SN
0 ESP32_GP9/ROMBL [reuse QSPI pins]
MCU1 Pin Count = 30 20+1+1+1+2+1+1+3
2 (DIO, SCK) Master
Shared SSI/XIP/QSPI bus
MCU2 Clock output
Wifi Module, ESP32-C3
Boot Button
N64_COLD_RESET
WS2812 LED
BOOT
N64_NMI
MCU2
SD-Card
USB connector
3-bit 8 out demux
RP2040 internal SRAM = 264 kB
8*CS (w/pull-ups)
N64_BUS
Small Flash
RUN (w/pull-down)
demux_IE
--- PSRAM Architecture --- MCU1, MCU2 and all PSRAMs are connected to SSI. Both can read/write. MCU1 and MCU2 are connected to a 3-bit, 8 output demux + IE pin. Demux is connected to each PSRAM's CS pin. --- N64 ROM --- MCU2 holds MCU1 in reset, fills PSRAM with data. MCU1 handles N64 bus requests,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
D+/D-
N64_INT
MCU2 Pin Count = 30 4+1+3+1+1+2+1 + 1+2+1+6+6+1
MC74AC138 fast 3-bit 8 output demultiplexer (active LOW)
MCU2_SPI_Slave
MCU1
MCU1_INT / MCU2_CS
6 (4DIO/SCK/CS)
Debug UART
4 (3 Addr, 1 InputEnable)
N64_S_DAT
N64_CIC

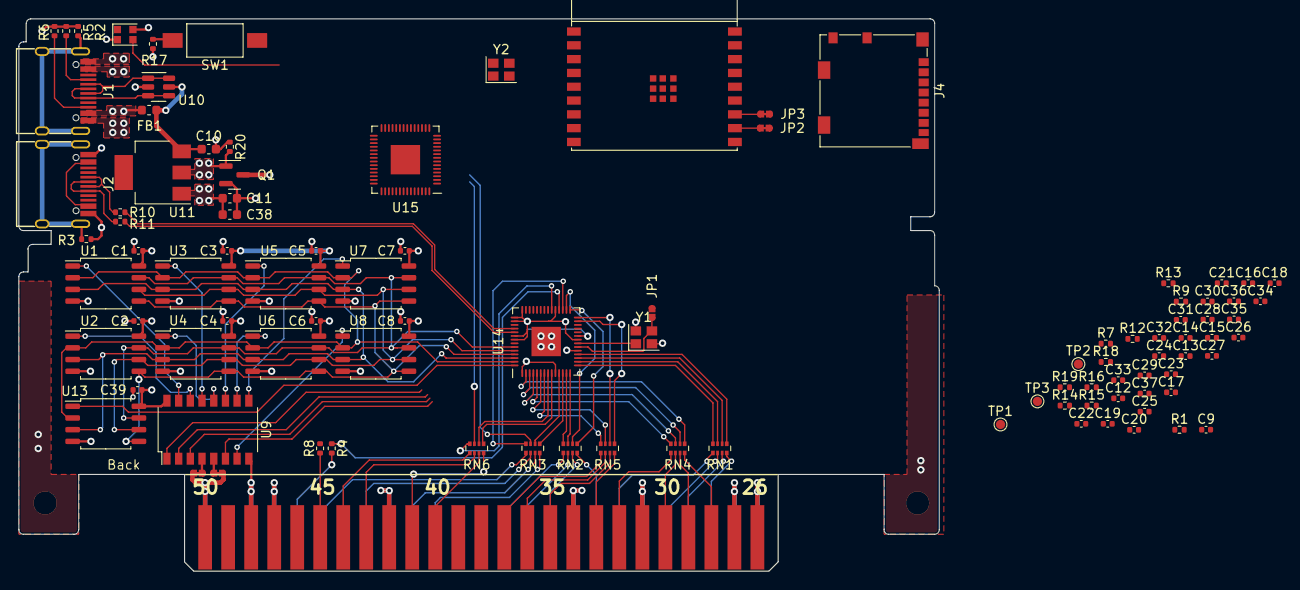
[picture p10: board picocart64_v2.kicad_pcb from above]

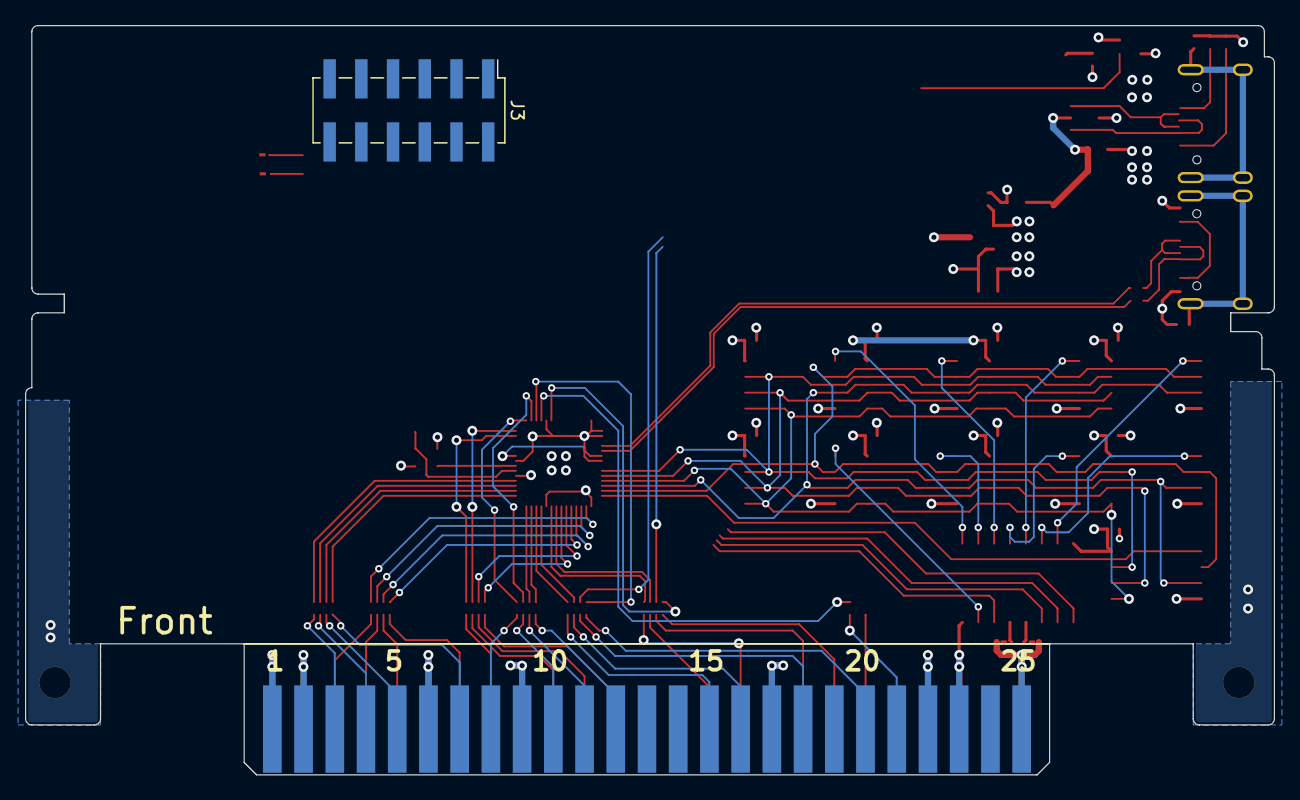
[picture p11: board picocart64_v2.kicad_pcb from below]

Board: 4 copper layers, 100.0 x 60.0 mm, 99 parts (2 on the bottom side), 127 nets.
