nikitalita/PicoCart64/(commit log)

2022-07-17 hw: Initialize picocart64_v2 project
    [picocart64_v2.kicad_pcb, picocart64_v2.kicad_sch]
2022-07-17 hw: v2 WIP
    [n64_cart.kicad_sch, picocart64_v2.kicad_sch, psram.kicad_sch]
2022-08-03 Break out sheets
    [board.kicad_sch, picocart64_v2.kicad_sch]
2022-08-03 Add overview
    [overview.kicad_sch, picocart64_v2.kicad_sch]
2022-08-04 Documented and figured out some stuff
    [board.kicad_sch, overview.kicad_sch, picocart64_v2.kicad_sch]
2022-08-04 Update text
    [overview.kicad_sch]
2022-08-09 hw: v2 Finalize schematic
    [board.kicad_sch, overview.kicad_sch, picocart64_v2.kicad_pcb, picocart64_v2.kicad_sch, psram.kicad_sch]
2022-08-11 hw: Routing progress
    [board.kicad_sch, picocart64_v2.kicad_pcb, picocart64_v2.kicad_sch, psram.kicad_sch]
2022-08-11 hw: More routing progress
    [picocart64_v2.kicad_pcb]
